ErikDorstel/midiKnobs/documentation/schematic with display.pdf

A

B

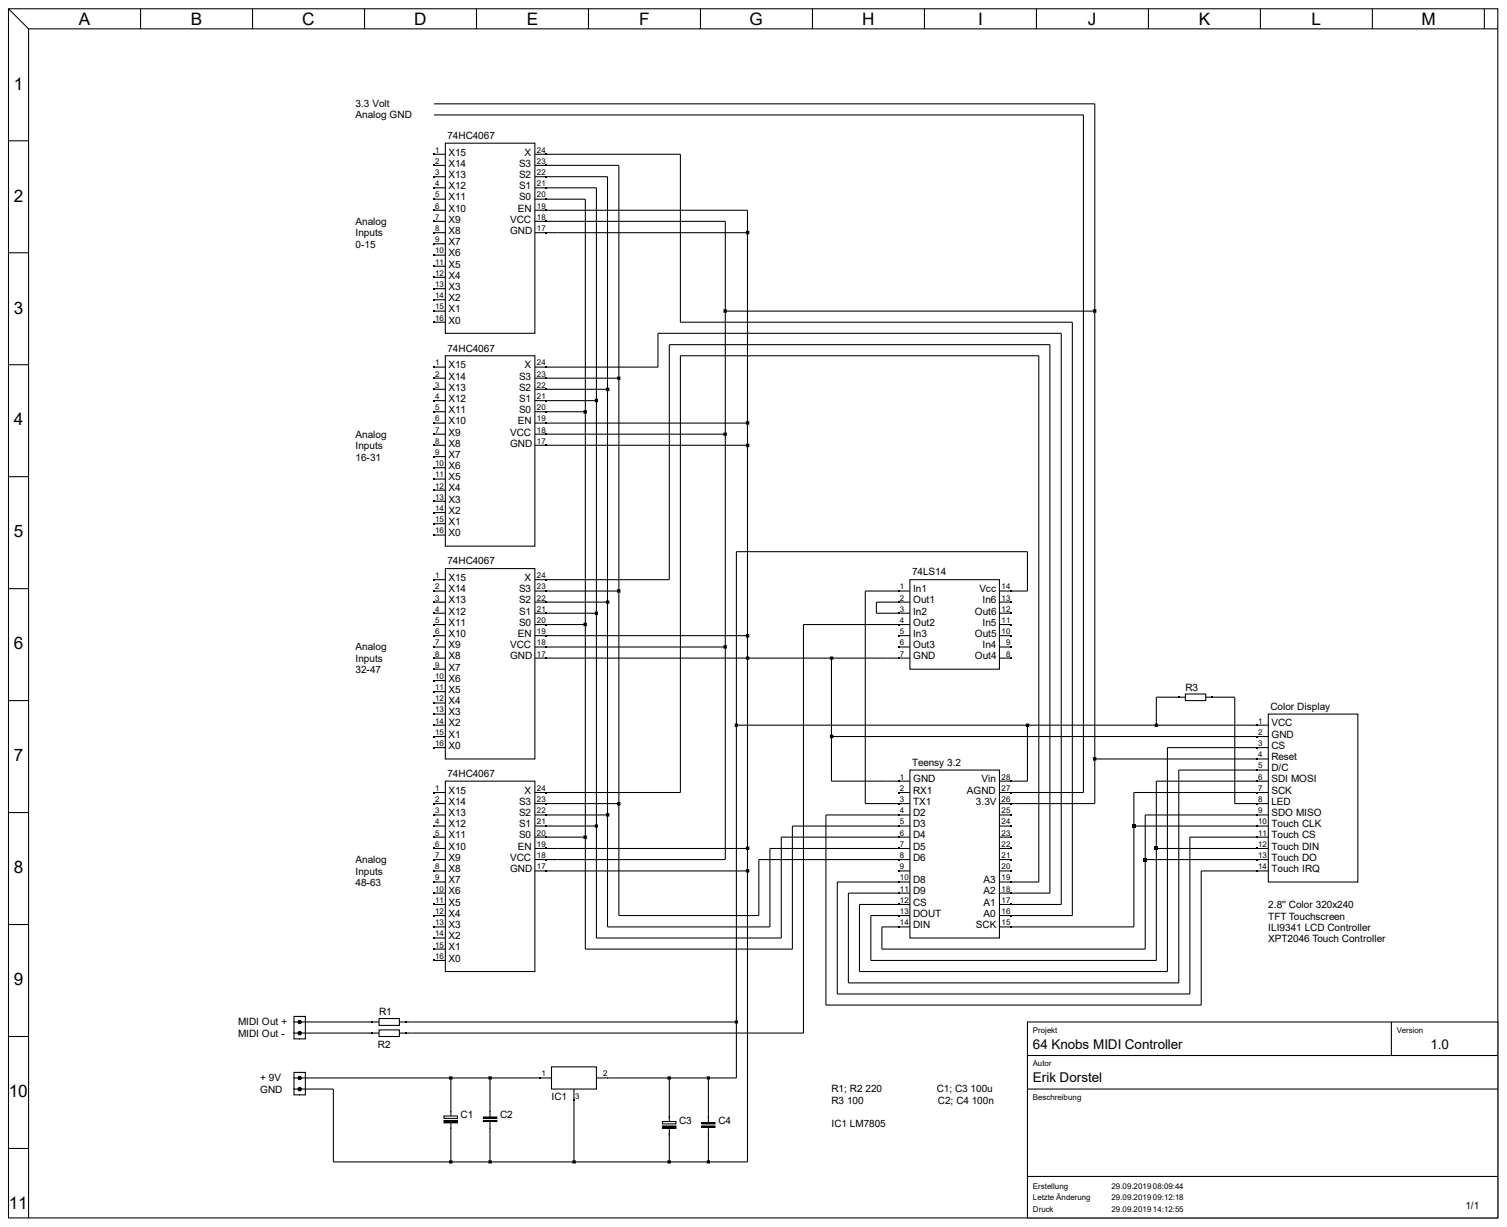
[picture p1: page 1]

67 SCK 8 LED 9 SDO MISO
SDI MOSI
