ErikDorstel/midiKnobs/documentation/schematic.pdf

A

B

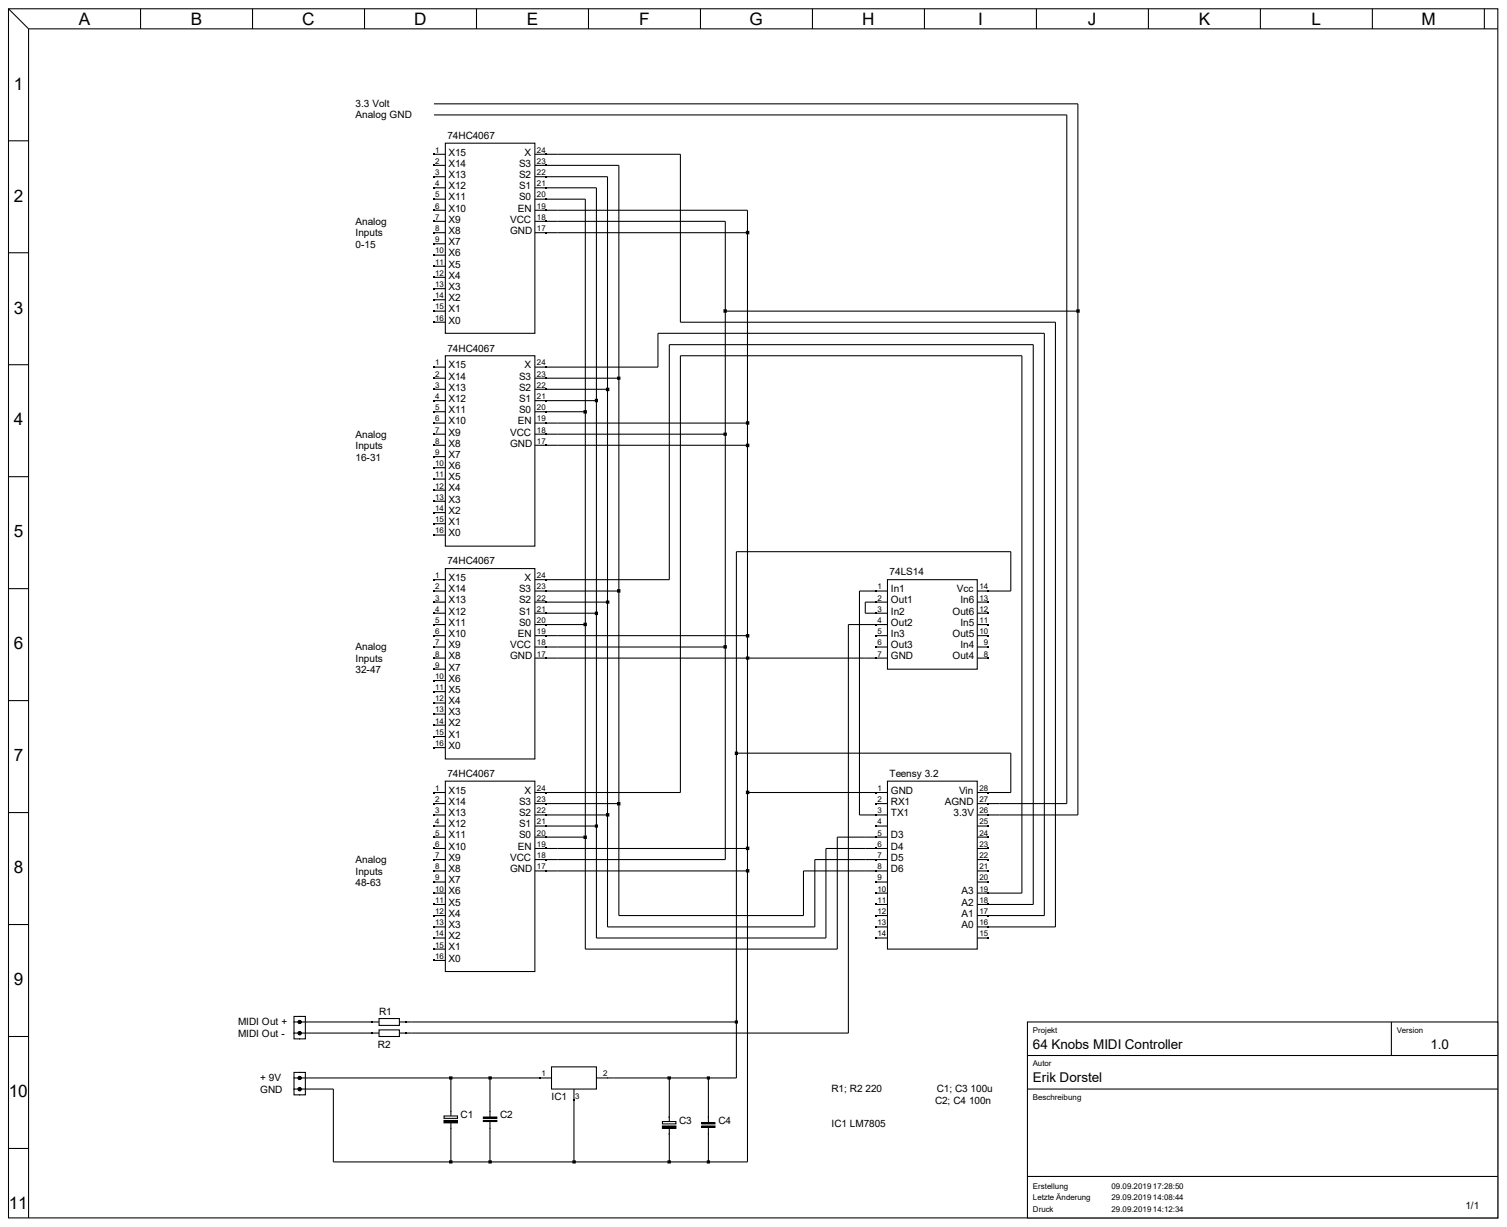
[picture p2: page 1]
